microfarad-de/li-charger/doc/li-charger-schematic.png

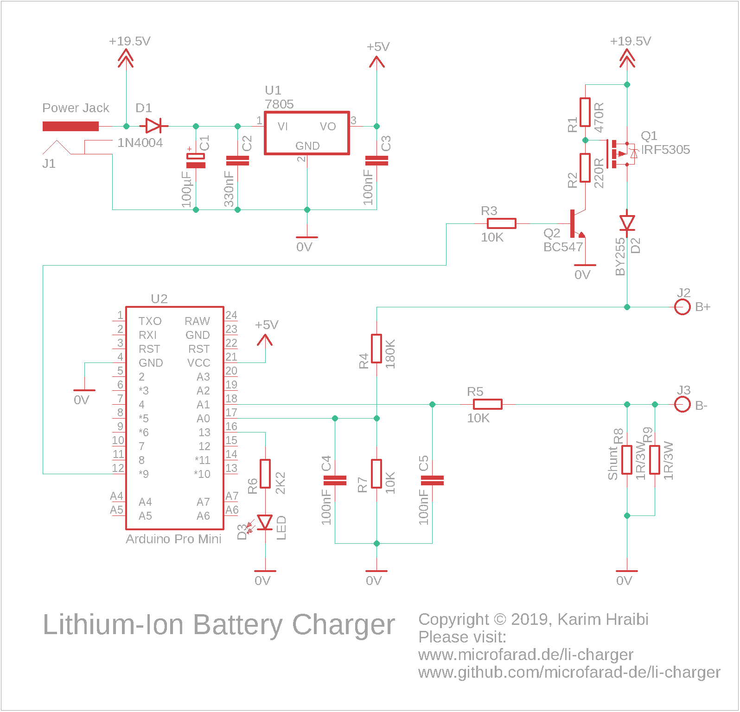
doc/li-charger-schematic.png
