microfarad-de/li-charger/(threads)

Thread 1 (2023-02-20):

Support for 5 cells ?

mtk11, 2023-02-20:
It seems currently 4 cells battery pack are maximum supported ? Possibility to support 5 cells – commonly used in various tools ? As well as simple step-up voltage converter ? Many of the available power supplies are up to 20V.
