microfarad-de/li-charger/li-charger.ino

/*
 * Lithium Battery Charger
 *
 * This source file is part of the Lithium-Ion Battery Charger Arduino firmware
 * found under http://www.github.com/microfarad-de/li-charger
 *
 * Please visit:
 *   http://www.microfarad.de
 *   http://www.github.com/microfarad-de
 *
 * Copyright (C) 2019 Karim Hraibi (khraibi at gmail.com)
 *
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
 * Version: 3.2.1
 * Date:    July 22, 2026
 */
#define VERSION_MAJOR 3  // major version
#define VERSION_MINOR 2  // minor version
#define VERSION_MAINT 1  // maintenance version

#include <avr/sleep.h>
#include <avr/power.h>
#include <avr/wdt.h>
#include <Arduino.h>
#include "src/Cli/Cli.h"
#include "src/Adc/Adc.h"
#include "src/Trace/Trace.h"
#include "src/Nvm/Nvm.h"
#include "src/Led/Led.h"
#include "src/MathMf/MathMf.h"

/*
 * Pin assignment
 */
#define NUM_APINS           2  // Number of analog pins in use
#define VOLTAGE_APIN ADC_PIN0  // Analog pin for voltage measurement
#define CURRENT_APIN ADC_PIN1  // Analog pin for current measurement
#define MOSFET_PIN          9  // PWM pin controlling the gate of the power MOSFET
#define LED_PIN   LED_BUILTIN  // LED pin


/*
 * Configuration parameters
 */
#define SERIAL_BAUD      115200 // Serial communication baud rate
#define V_SURGE         4250000 // 4.25 V - maximum allowed surge voltage threshold per cell in µV
#define V_MAX           4200000 // 4.20 V - Maximum allowed battery voltage per cell in µV
#define V_MIN           2500000 // 2.50 V - Minimum allowed battery voltage per cell in µV
#define V_START           V_MIN // 2.50 V - Minimum allowed battery voltage per cell in µV for starting a charge
#define V_SAFE          2800000 // 2.80 V - Charge with reduced current I_safe below this voltage per cell in µV
#define V_WINDOW           2000 // 0.002 V - Do not regulate voltage when within +/- this window (per cell) in µV
#define V_TRICKLE_START 4100000 // 4.10 V - Trickle charge threshold voltage in µV
#define V_TRICKLE_MAX   4150000 // 4.15 V - Trickle charge maximum voltage in µV
#define I_WINDOW          15000 // 0.015 A - Do not regulate current when within +/- this window in µA
#define I_DIVIDER           128 // Divider constant used for current calculation
#define I_SAFE_DIVIDER       10 // Divide I_chrg by this value to calculate I_safe, which is the reduced safety charging current
#define DELAY_CHARGE       2000 // Time duration in ms during which V shall be between V_MIN and V_MAX before starting to charge
#define DELAY_ERROR         150 // Time duration in ms during which i or V shall be out of bounds in order to trigger an error condition
#define DELAY_FULL        20000 // Time duration in ms during which I_full shall not be exceeded in order to assume that battery is full
#define DELAY_TRICKLE      5000 // Time duration in ms during which V shall be smaller than V_TRICKLE_MAX before starting a trickle charge
#define DELAY_ERR_RST      2000 // Time duration in ms during which V shall be 0 before going back from STATE_ERROR to STATE_INIT
#define DELAY_FULL_RST     2000 // Time duration in ms during which V shall be 0 before going back from STATE_FULL to STATE_INIT
#define DELAY_UPDATE_UP      20 // Number of ADC conversions for increasing the power output by one increment
#define DELAY_UPDATE_DN       1 // Number of ADC conversions  for decreasing the power output by one increment
#define PWM_OC_DETECT_THR   150 // PWM value threshold - detect open circuit if I = 0 while PWM exceeds this value
#define ADC_AVG_SAMPLES      16 // Number of ADC samples to be averaged
#define SOC_LUT_SIZE          9 // Size of the state-of-charge lookup table
#define TRACE_BUF_SIZE      240 // Trace buffer size
#define TRACE_RESOLUTION  60000 // Trace timestamp resolution in ms




/*
 * Objects
 */
LedClass Led;
TraceClass Trace;

/*
 * State machine states
 */
enum State_t { STATE_INIT_E, STATE_INIT, STATE_CHARGE_E, STATE_CHARGE, STATE_FULL_E, STATE_FULL,
                STATE_ERROR_E, STATE_ERROR, STATE_CALIBRATE_E, STATE_CALIBRATE };

/*
 * Global variables
 */
struct {
  State_t state = STATE_INIT_E; // Current state machine state
  uint32_t v1;           // V1 - Voltage at the battery '+' terminal (MOSFET drain) in µV
  uint32_t v2;           // V2 - Voltage at the battery '-' terminal (shunt) in µV
  uint32_t v;            // V  - Battery voltage = V1 - V2 in µV
  uint32_t vMax;         // Maximum allowed battery voltage during charging in µV
  uint32_t i;            // I - Charging current in µA
  uint32_t iMax;         // I_max - Maximum charging current in µA
  uint32_t tMax;         // T_max - Maximum allowed charge time duration in s
  uint32_t iCalibration; // Calibration value for calculating i
  uint32_t c = 0;        // Total charged capacity in mAs
  uint32_t cMax;         // C_max - Maximum allowed charge capacity in mAs
  uint32_t t = 0;        // Charge duration in s
  uint32_t tUpdate;      // Regulation loop update interval in ms
  uint32_t adcTick = 0;  // ADC conversion counter, increments when new ADC results are available
  uint16_t v1Raw;        // Raw ADC value of V1
  uint16_t v2Raw;        // Raw ADC value of V2
  uint16_t iSafe;        // I_safe - Charging current in mA when the battery voltage is below V_SAFE
  uint8_t dutyCycle;     // PWM duty cycle
  char *stateStr;        // Pointer to a string describing the current state
  bool crcOk = false;    // EEPROM CRC check was successful
} G;



/*
 * Parameters stored in EEPROM (non-volatile memory)
 */
struct {
  uint32_t v1Cal;               // V1_cal - Calibration constant for calculating V1
  uint32_t v2Cal;               // V2_cal - Calibration constant for calculating V2
  uint16_t iFull;               // I_full - End of charge current in mA
  uint16_t iChrg;               // I_chrg - Maximum charging current in mA
  uint16_t rShunt;              // R_shunt - Shunt resistor value in mΩ
  uint16_t cFull;               // C_full - Full charge capacity in mAh
  uint8_t  numCells;            // N_cells - Number of Lithium-Ion cells
  uint16_t socLut[SOC_LUT_SIZE];// State-of-charge lookup table - contains voltages in mV
  uint32_t crc;                 // CRC checksum
} Nvm;


/*
 * Strings to be reused for saving memory
 */
const struct {
  char *N_cells = (char *)"N_cells = %u\n";
  char *C_full  = (char *)"C_full  = %umAh\n";
  char *I_chrg  = (char *)"I_chrg  = %umA\n";
  char *I_safe  = (char *)"I_safe  = %umA\n";
  char *I_full  = (char *)"I_full  = %umA\n";
  char *R_shunt = (char *)"R_shunt = %umΩ\n";
  char *V1_cal  = (char *)"V1_cal  = %lu\n";
  char *V2_cal  = (char *)"V2_cal  = %lu\n";
  char *I_cal   = (char *)"I_cal   = %lu\n";
  char *CRC     = (char *)"CRC = %lx\n\n";
  char *reached = (char *)" reached";
  char *Calibration = (char *)"Calibration";
  char *start   = (char *)"start";
  char *stop    = (char *)"stop";
} Str;



/*
 * Function prototypes
 */
bool nvmValidate (void);
void nvmRead (void);
bool nvmWrite (void);
void calcTmaxCmax (bool);
void adcRead (void);
int cmdStatus (int, char **);
int cmdEEPROM (int, char **);
int cmdNcells (int, char **);
int cmdIchrg (int, char **);
int cmdCfull (int, char **);
int cmdIfull (int, char **);
int cmdRshunt (int, char **);
int cmdLut (int, char **);
void calibrateV1 (uint32_t);
void calibrateV2 (uint32_t);
int cmdCal (int, char **);
int cmdTrace (int, char **);




/*
 * Validate the settings
 * Called after reading or before writing EEPROM
 * Always fall-back to the safest possible values
 * Return value:
 *   true  : validation OK
 *   false : validation error
 */
bool nvmValidate (void) {
  bool rv = true;
  if (Nvm.numCells < 0 || Nvm.numCells > 6)         Nvm.numCells = 1          , rv = false;
  if (Nvm.iChrg < 100 || Nvm.iChrg > 2000)          Nvm.iChrg = 100           , rv = false;
  if (Nvm.iFull < 20 || Nvm.iFull > Nvm.iChrg - 20) Nvm.iFull = Nvm.iChrg - 20, rv = false;
  if (Nvm.v1Cal < 4000 || Nvm.v1Cal > 40000)        Nvm.v1Cal = 40000         , rv = false;
  if (Nvm.v2Cal < 800  || Nvm.v2Cal > 1200 )        Nvm.v2Cal = 1200          , rv = false;
  if (Nvm.cFull < 10 || Nvm.cFull > 10000 )         Nvm.cFull = 10            , rv = false;
  if (Nvm.rShunt < 100 || Nvm.rShunt > 1000)        Nvm.rShunt = 100          , rv = false;

  // Calculate current calibration value
  G.iCalibration = ((uint32_t)I_DIVIDER * 1000) / (uint32_t)Nvm.rShunt;

  // Calculate the safe charging current
  G.iSafe = Nvm.iChrg / (uint16_t)I_SAFE_DIVIDER;

  return rv;
}


/*
 * Read and validate EEPROM data
 */
void nvmRead (void) {
  uint32_t crc;

  eepromRead (0x0, (uint8_t*)&Nvm, sizeof (Nvm));
  nvmValidate ();

  // Calculate and check CRC checksum
  crc = crcCalc ((uint8_t*)&Nvm, sizeof (Nvm) - sizeof (Nvm.crc) );
  Cli.xprintf (Str.CRC, crc);

  if (crc != Nvm.crc) G.crcOk = false;
  else G.crcOk = true;
}


/*
 * Write and validate EEPROM data
 * Return value:
 *   true  : validation OK
 *   false : validation error
 */
bool nvmWrite (void) {
  if (nvmValidate ()) {
    Nvm.crc = crcCalc ((uint8_t*)&Nvm, sizeof (Nvm) - sizeof (Nvm.crc) );
    eepromWrite (0x0, (uint8_t*)&Nvm, sizeof (Nvm));
    return true;
  }
  else {
    Cli.xputs ("Out of range");
    return false;
  }
}


/*
 * Claculate the values of
 * the maximum charge duration T_max and
 * the maximum charge capacity C_max
 */
void calcTmaxCmax (bool trickleCharge) {
  uint8_t i, soc;

  // Detect charge state using the lookup table
  for (i = 0; i < SOC_LUT_SIZE; i++) {
    if (G.v < (uint32_t)Nvm.socLut[i] * 1000 * (uint32_t)Nvm.numCells) break;
  }

  // Calculate the state of charge
  soc = (i * 100) / (SOC_LUT_SIZE + 1);

  //Cli.xprintf ("V   = %lu mV\n", G.v / 1000);
  Cli.xprintf ("SoC = %u %%\n", soc);
  Cli.xputs ("");

  /* Calculate the maximum allowed charge duration
     Assume linear increase with capacity intil 80% of charge (constant current phase),
     then add a constant duration of 45 min for the remaining top-off charge (constant voltage phase).
     T_max (s) = 3600 * (C_full / I_chrg) * (90 - SoC) / 100 + 45 * 60s + T_safe
  */
  if (!trickleCharge) {
    // 36 = 3600 / 100
    G.tMax = ( 36 * (90 - soc) * (uint32_t)Nvm.cFull ) / (uint32_t)Nvm.iChrg + 45 * 60;
  }
  else {
    // Allow for 20 charging minutes in every trickle charge cycle
    G.tMax = 20 * 60 + G.t;
  }

  /* Calculate the maximum allowed charge capacity
     C_max (mAs) = 3600 * C_full * 1.31 * (100 - SoC) / 100
     Equals remaining capacity + 31%: 47 = 3600 * 1.31 / 100
  */
  if (!trickleCharge) {
    G.cMax = 47 * (100 - soc) * (uint32_t)Nvm.cFull;
  }
  else {
    // Top-up 3% of C_full for every trickle charge cycle
    G.cMax = 36 * 3 * (uint32_t)Nvm.cFull + G.c;
  }
  Trace.log ('%', soc);
  Trace.log ('v', G.v / 1000);
  Trace.log ('T', G.tMax / 60);
  Trace.log ('C', G.cMax / 3600);
}




/*
 * Arduino initalization routine
 */
void setup (void) {

  MCUSR = 0;      // clear MCU status register
  wdt_disable (); // and disable watchdog

  // Initialize the Timer 1 PWM frequency for pins 9 and 10
  // See https://docs.arduino.cc/tutorials/generic/secrets-of-arduino-pwm/
  // See https://nerdytechy.com/how-to-change-the-pwm-frequency-of-arduino/
  // See https://etechnophiles.com/change-frequency-pwm-pins-arduino-uno/
  // See ATmega328P datasheet Section 20.14.2, Table 20-7
  TCCR1B = (TCCR1B & B11111000) | B00000001; // For PWM frequency of 31372.55Hz (using 16MHz crystal)

  // Configure all unused pins as INPUT_PULLUP to avoid
  // excessive power draw due to toggling floating pins
  // except crystal pins
  DDRB  = 0x00;
  DDRC  = 0x00;
  DDRD  = 0x00;
  PORTB = 0x3F;   // D8–D13 pull-ups enabled
  PORTC = 0x3F;   // A0–A5 pull-ups enabled
  PORTD = 0xFF;   // D0–D7 pull-ups enabled

  // Initialize pins
  pinMode (A0, INPUT);
  pinMode (A1, INPUT);
  pinMode (MOSFET_PIN, OUTPUT);

  // Initialize the command-line interface
  Cli.init (SERIAL_BAUD);
  Cli.xputs ("");
  Cli.xputs ("+ + +  L I  C H A R G E R  + + +");
  Cli.xputs ("");
  Cli.xprintf ("V %d.%d.%d\n", VERSION_MAJOR, VERSION_MINOR, VERSION_MAINT);
  Cli.xputs ("");
  Cli.newCmd (".", "System status", cmdStatus);
  Cli.newCmd ("r", "EEPROM status", cmdEEPROM);
  Cli.newCmd ("t", "Dump trace", cmdTrace);
  Cli.newCmd ("ncells", "Set N_cells", cmdNcells);
  Cli.newCmd ("cfull", "Set C_full (arg: <mAh>)", cmdCfull);
  Cli.newCmd ("ichrg", "Set I_chrg (arg: <mA>)", cmdIchrg);
  Cli.newCmd ("ifull", "Set I_full (arg: <mA>)", cmdIfull);
  Cli.newCmd ("lut", "Set LUT (arg: <idx> <mV>)", cmdLut);
  Cli.newCmd ("rshunt", "Set R_shunt (arg: <mΩ>)", cmdRshunt);
  Cli.newCmd ("cal", "Calibrate (arg: <start|stop|v1|v2> [mV])", cmdCal);

  Cli.showHelp ();

  // Initialize the ADC
  Adc.initialize (ADC_PRESCALER_128, ADC_INTERNAL, NUM_APINS, ADC_AVG_SAMPLES);

  // Initialize LED
  Led.initialize (LED_PIN);

  // Read the settngs from EEPROM and validate them
  nvmRead ();

  // Initialize the trace buffer
  Trace.initialize (sizeof(Nvm), TRACE_BUF_SIZE, TRACE_RESOLUTION);

  // Enable the watchdog
  wdt_enable (WDTO_1S);
}


/*
 * Arduino main loop
 */
void loop (void) {
  static uint32_t tickTs = 0;
  static uint32_t updateTs = 0;
  static uint32_t chargeTs = 0;
  static uint32_t errorTs = 0;
  static uint32_t fullTs = 0;
  static uint32_t trickleTs = 0;
  static uint32_t resetTs = 0;
  static uint16_t traceCount = 0;
  static bool safeCharge = true;
  static bool trickleCharge = false;
  uint32_t ts = millis ();

  // Reset the watchdog timer
  wdt_reset ();

  // Enter the power save mode - reduces accuracy of c calculation
  //powerSave ();

  // Command-line interpreter
  Cli.getCmd ();

  // Update the LED state
  Led.loopHandler ();

  // Update the trace timestamp - must be called after 'ts = millis ()'
  Trace.loopHandler ();

  // Read the ADC channels
  adcRead ();

  // Force the error STATE if CRC error occurred
  if (!G.crcOk && G.state != STATE_ERROR) Cli.xprintf ("CRC "), Trace.log ('E', 99), G.state = STATE_ERROR_E;


  // Main state machine
  switch (G.state) {

    /********************************************************************/
    // Initialization State
    case STATE_INIT_E:
      Led.blink (-1, 500, 1500);
      trickleCharge = false;
      Trace.reset ();
      G.vMax = (uint32_t)V_MAX * Nvm.numCells;
      chargeTs = ts;
      G.dutyCycle = 0;
      analogWrite (MOSFET_PIN, 0);
      G.stateStr = (char *)"Waiting for battery";
      Cli.xputs (G.stateStr);
      Cli.xputs ("");
      G.state = STATE_INIT;
    case STATE_INIT:
      // Start charging if V stays within bounds during DELAY_CHARGE
      if ( G.v < (uint32_t)V_START * Nvm.numCells || G.v > G.vMax ) chargeTs = ts;
      if (ts - chargeTs > DELAY_CHARGE) {
        G.c = 0;
        G.t = 0;
        G.state = STATE_CHARGE_E;
      }
      break;

    /********************************************************************/
    // Charging State
    case STATE_CHARGE_E:
      Led.turnOn ();
      errorTs = ts;
      fullTs = ts;
      tickTs = ts;
      updateTs = G.adcTick;
      G.iMax = (uint32_t)G.iSafe * 1000;
      safeCharge = true;
      Trace.start ();
      traceCount = 0;
      if (trickleCharge) {
        G.vMax = (uint32_t)V_TRICKLE_MAX * Nvm.numCells; // Reduce vMax to trickle charge level
        G.stateStr = (char *)"Trickle charging";
      }
      else  {
        G.vMax = (uint32_t)V_MAX * Nvm.numCells; // Set vMax to full charge level
        G.stateStr = (char *)"Charging";
      }
      Cli.xputs (G.stateStr);
      Cli.xputs ("");
      Trace.log ('*', G.vMax / 1000);
      calcTmaxCmax (trickleCharge);
      if (G.v <= (uint32_t)V_SAFE * Nvm.numCells) Trace.log ('S', G.iMax / 1000);
      G.state = STATE_CHARGE;

    case STATE_CHARGE:
      // Temporarily increase the PWM update rate to mitigate voltage or current surge conditions
      if ( ( G.v > G.vMax + 10 * (uint32_t)V_WINDOW * Nvm.numCells ) ||
           ( G.i > G.iMax + 10 * (uint32_t)I_WINDOW ) ) {
        G.tUpdate = (uint32_t)DELAY_UPDATE_DN;
      }
      else {
        G.tUpdate = (uint32_t)DELAY_UPDATE_UP;
      }

      // CC-CV Regulation:
      // Run the regulation routine at the preset interval
      if (G.adcTick - updateTs > G.tUpdate) {
        updateTs = G.adcTick;
        // Regulate voltage and current with the CC-CV algorithm
        if ( ( G.v > G.vMax + (uint32_t)V_WINDOW * Nvm.numCells ) ||
             ( G.i > G.iMax + (uint32_t)I_WINDOW ) ) {
          if (G.dutyCycle > 0) G.dutyCycle--;
        }
        else if ( ( G.v < G.vMax - (uint32_t)V_WINDOW * Nvm.numCells ) &&
                  ( G.i < G.iMax - (uint32_t)I_WINDOW ) ) {
          if (G.dutyCycle < 255) G.dutyCycle++;
        }
        // Update the PWM duty cycle
        analogWrite (MOSFET_PIN, G.dutyCycle);
      }

      // Set the charging current
      if (G.v > (uint32_t)V_SAFE * Nvm.numCells && safeCharge) {
        safeCharge = false;
        G.iMax = (uint32_t)Nvm.iChrg * 1000;
        Trace.log ('I', G.iMax / 1000);
      }

      // Error Detection:
      // Signal an error if V stays out of bounds or open circuit condition occurs during DELAY_ERROR
      if ( G.v > (uint32_t)V_MIN   * Nvm.numCells &&
           G.v < (uint32_t)V_SURGE * Nvm.numCells &&
           !( G.i == 0 && G.dutyCycle > PWM_OC_DETECT_THR ) ) errorTs = ts;
      if (ts - errorTs > DELAY_ERROR) {
        cmdStatus (0, NULL);
        if (G.v > (uint32_t)V_SURGE * Nvm.numCells)       Cli.xprintf ("Overvolt "), Trace.log ('E', 1);
        if (G.v < (uint32_t)V_MIN * Nvm.numCells  )       Cli.xprintf ("Undervolt "), Trace.log ('E', 2);
        if (G.i == 0 && G.dutyCycle > PWM_OC_DETECT_THR)  Cli.xprintf ("Open circuit "), Trace.log ('E', 3);
        G.state = STATE_ERROR_E;
      }

      // End of Charge Detection:
      // Report battery full if I_full has not been exceeded during DELAY_FULL (ignore during safety charging)
      if ( G.i > (uint32_t)Nvm.iFull * 1000 || safeCharge ) fullTs = ts;
      if (ts - fullTs > DELAY_FULL) {
        cmdStatus (0, NULL);
        Cli.xprintf("I_full");
        Cli.xputs(Str.reached);
        Trace.log ('F', 1);
        G.state = STATE_FULL_E;
      }

      // Calculate charged capacity by integrating i over time
      if (ts - tickTs >= 1000 /* && !trickleCharge */) {
        tickTs += 1000;
        G.t++;
        G.c += (G.i / 1000);
        traceCount++;
        if (traceCount >= 120) {
          Trace.log ('v', G.v / 1000);
          Trace.log ('i', G.i / 1000);
          traceCount = 0;
        }
      }

      // End of Charge Detection:
      // Maximum charge capacity is reached
      if (G.c > G.cMax) {
        cmdStatus (0, NULL);
        Cli.xprintf ("C_max"); Cli.xputs(Str.reached);
        Trace.log ('F', 2);
        G.state = STATE_FULL_E;
      }

      // End of Charge Detection:
      // Maximum charge duration reached
      if (G.t > G.tMax) {
        cmdStatus (0, NULL);
        Cli.xprintf ("T_max"); Cli.xputs(Str.reached);
        Trace.log ('F', 3);
        G.state = STATE_FULL_E;
      }
      break;

    /********************************************************************/
    // Battery Full State
    case STATE_FULL_E:
      Led.blink (-1, 100, 1900);
      trickleTs = ts;
      resetTs = ts;
      G.dutyCycle = 0;
      analogWrite (MOSFET_PIN, 0);
      G.stateStr = (char *)"Battery full";
      Cli.xputs (G.stateStr);
      Cli.xputs ("");
      Trace.log ('t', G.t / 60);
      Trace.log ('c', G.c / 3600);
      Trace.log ('v', G.v / 1000);
      Trace.log ('i', G.i / 1000);
      G.state = STATE_FULL;
    case STATE_FULL:
      // Start a trickle charging cycle if V_TRICKLE_START has not been exceeded during DELAY_TRICKLE
      if (G.v > (uint32_t)V_TRICKLE_START * Nvm.numCells) trickleTs = ts;
      if (ts - trickleTs > DELAY_TRICKLE) {
        cmdStatus (0, NULL);
        trickleCharge = true;
        G.state = STATE_CHARGE_E;
      }
      // Go to STATE_INIT if V stayed 0 during DELAY_RESET
      if (G.v > 0) resetTs = ts;
      if (ts - resetTs > DELAY_FULL_RST) G.state = STATE_INIT_E;
      break;

    /********************************************************************/
    // Error State
    case STATE_ERROR_E:
      Led.blink (-1, 200, 200);
      resetTs = ts;
      G.dutyCycle = 0;
      analogWrite (MOSFET_PIN, 0);
      G.stateStr = (char *)"ERROR";
      Cli.xputs (G.stateStr);
      Cli.xputs ("");
      Trace.log ('t', G.t / 60);
      Trace.log ('c', G.c / 3600);
      Trace.log ('v', G.v / 1000);
      Trace.log ('i', G.i / 1000);
      G.state = STATE_ERROR;
    case STATE_ERROR:
      // Go to STATE_INIT if V stayed 0 during DELAY_RESET
      if (G.v > 0) resetTs = ts;
      if (ts - resetTs > DELAY_ERR_RST && G.crcOk) G.state = STATE_INIT_E;
      break;


    /********************************************************************/
    // Calibration State
    case STATE_CALIBRATE_E:
      Led.blink (-1, 100, 100);
      G.dutyCycle = 0;
      analogWrite (MOSFET_PIN, 0);
      G.stateStr = Str.Calibration;
      G.state = STATE_CALIBRATE;
    case STATE_CALIBRATE:
      // Do nothing and wait for a CLI command
      break;

    /********************************************************************/
    default:
      break;
  }
}





/*
 * Read the ADC channels
 */
void adcRead (void) {
  bool result;

  // Read the ADC channels
  result = Adc.readAll ();

  if (result) {
    // Get the ADC results
    G.v1Raw = (uint16_t)Adc.result[VOLTAGE_APIN];
    G.v2Raw = (uint16_t)Adc.result[CURRENT_APIN];

    // Calculate voltage and current
    G.v1 = (uint32_t)G.v1Raw * Nvm.v1Cal;
    G.v2 = (uint32_t)G.v2Raw * Nvm.v2Cal;
    G.v  = G.v1 - G.v2;
    G.i  = ( (uint32_t)G.v2 * G.iCalibration ) / I_DIVIDER ;
    G.adcTick++;
  }
}


/*
 * Power-save routine, sends the CPU into sleep mode
 */
void powerSave (void) {
  // configure lowest sleep mode that keeps clk_IO for Timer 1 used for PWM generation
  set_sleep_mode (SLEEP_MODE_IDLE);

  // enter sleep, wakeup will be triggered by the next millis() interrupt
  cli ();
  sleep_enable ();
  sei ();
  sleep_cpu ();
  sleep_disable ();
}





/*
 * CLI command for showing the real-time parameters
 * These values are continuously updated during runtime.
 */
int cmdStatus (int argc, char **argv) {
  uint32_t hour = G.t / 3600;
  uint32_t min = G.t / 60 - (hour * 60);
  uint32_t sec = G.t - (hour * 3600) - (min * 60);
  Cli.xprintf ("state  = %s\n", G.stateStr);
  Cli.xprintf ("T      = %02u:%02u:%02u\n", (uint8_t)hour, (uint8_t)min, (uint8_t)sec);
  Cli.xprintf ("C      = %lumAh\n", G.c / 3600);
  Cli.xprintf ("V      = %lumV\n", G.v / 1000);
  Cli.xprintf ("I      = %lumA\n", G.i / 1000);
  Cli.xprintf ("T_max  = %lumin\n", G.tMax / 60);
  Cli.xprintf ("C_max  = %lumAh\n", G.cMax / 3600);
  Cli.xprintf ("V_max  = %lumV\n", G.vMax / 1000);
  Cli.xprintf ("I_max  = %lumA\n", G.iMax / 1000);
  Cli.xprintf ("PWM    = %u\n", G.dutyCycle);
  Cli.xprintf ("V1     = %lumV\n", G.v1 / 1000);
  Cli.xprintf ("V2     = %lumV\n", G.v2 / 1000);
  Cli.xprintf ("V1_raw = %u\n", G.v1Raw);
  Cli.xprintf ("V2_raw = %u\n", G.v2Raw);
  Cli.xputs ("");
  return 0;
}


/*
 * CLI command for showing calibration parameters
 * These values do not change during runtime.
 * They are either directly read from EEPROM or
 * derived from other EEPROM values.
 */
int cmdEEPROM (int argc, char **argv) {
  uint8_t i;
  Cli.xprintf (Str.N_cells, Nvm.numCells);
  Cli.xprintf (Str.C_full,  Nvm.cFull);
  Cli.xprintf (Str.I_chrg,  Nvm.iChrg);
  Cli.xprintf (Str.I_safe,  G.iSafe);
  Cli.xprintf (Str.I_full,  Nvm.iFull);
  Cli.xprintf (Str.R_shunt, Nvm.rShunt);
  Cli.xprintf (Str.V1_cal,  Nvm.v1Cal);
  Cli.xprintf (Str.V2_cal,  Nvm.v2Cal);
  Cli.xprintf (Str.I_cal,   G.iCalibration);
  Cli.xprintf ("LUT = ");
  for (i = 0; i < SOC_LUT_SIZE; i++) Cli.xprintf("%u ", Nvm.socLut[i]);
  Cli.xputs ("");
  Cli.xputs ("");
  return 0;
}


/*
 * CLI command for setting the number of cells
 * argv[1]: number of cells
 */
int cmdNcells (int argc, char **argv) {
  if (argc != 2) return 1;
  uint8_t tmp = Nvm.numCells;
  Nvm.numCells = atoi (argv[1]);
  if (nvmWrite ()) Cli.xprintf (Str.N_cells, Nvm.numCells);
  else             Nvm.numCells = tmp;
  Cli.xputs ("");
  G.state = STATE_INIT_E;
  return 0;
}


/*
 * CLI command for setting the charge current
 * argv[1]: current in mA
 */
int cmdIchrg (int argc, char **argv) {
  if (argc != 2) return 1;
  uint16_t tmp1 = Nvm.iChrg;
  uint16_t tmp2 = Nvm.iFull;
  Nvm.iChrg = atoi (argv[1]);
  if (nvmWrite ()) {
    Cli.xprintf(Str.I_chrg, Nvm.iChrg);
  }
  else {
    Nvm.iChrg = tmp1;
    Nvm.iFull = tmp2;
  }
  Cli.xputs("");
  return 0;
}


/*
 * CLI command for setting the end of charge current
 * argv[1]: current in mA
 */
int cmdIfull (int argc, char **argv) {
  if (argc != 2) return 1;
  uint16_t tmp = Nvm.iFull;
  Nvm.iFull = atoi (argv[1]);
  if (nvmWrite ()) Cli.xprintf(Str.I_full, Nvm.iFull);
  else             Nvm.iFull = tmp;
  Cli.xputs("");
  return 0;
}


/*
 * CLI command for setting the battery capacity
 * argv[1]: battery capacity in mAh
 */
int cmdCfull (int argc, char **argv) {
  if (argc != 2) return 1;
  uint16_t tmp = Nvm.cFull;
  Nvm.cFull = atoi (argv[1]);
  if (nvmWrite ()) Cli.xprintf(Str.C_full, Nvm.cFull);
  else             Nvm.cFull = tmp;
  Cli.xputs("");
  return 0;
}


/*
 * CLI command for setting the shunt resistor value
 * argv[1]: shunt resistance in mΩ
 */
int cmdRshunt (int argc, char **argv) {
  if (argc != 2) return 1;
  uint16_t tmp = Nvm.rShunt;
  Nvm.rShunt = atoi (argv[1]);
  if (nvmWrite ()) {
    Cli.xprintf(Str.R_shunt, Nvm.rShunt);
    Cli.xprintf(Str.I_cal, G.iCalibration);
  }
  else {
    Nvm.rShunt = tmp;
  }
  Cli.xputs("");
  return 0;
}


/*
 * CLI command for filling the state-of-charge lookup table
 * argv[1]: idx [0..8]
 *          V = LUT [idx]
 *          idx:    0     1     2     3     4     5     6     7     8
 *          SoC: 0% | 10% | 20% | 30% | 40% | 50% | 60% | 70% | 80% | 90%
 * argv[2]: voltage in mV per cell
 */
int cmdLut (int argc, char **argv) {
  if (argc != 3) return 1;
  uint8_t idx = (uint8_t)atoi (argv[1]);
  if (idx > SOC_LUT_SIZE - 1) return 1;
  Nvm.socLut[idx] = atoi (argv[2]);
  nvmWrite ();
  Cli.xprintf ("LUT[%u] = %u\n", idx, Nvm.socLut[idx]);
  Cli.xputs ("");
  return 0;
}


/*
 * Calibrate V1
 */
void calibrateV1 (uint32_t vRef) {
  uint32_t tmp = Nvm.v1Cal;
  Nvm.v1Cal = (uint32_t)vRef / (uint32_t)G.v1Raw;
  if (nvmWrite ()) Cli.xprintf (Str.V1_cal, Nvm.v1Cal);
  else             Nvm.v1Cal = tmp;
  Cli.xputs ("");
}


/*
 * Calibrate V2
 */
void calibrateV2 (uint32_t vRef) {
  uint32_t tmp = Nvm.v2Cal;
  Nvm.v2Cal = (uint32_t)vRef / (uint32_t)G.v2Raw;
  if (nvmWrite ()) Cli.xprintf (Str.V2_cal, Nvm.v2Cal);
  else             Nvm.v2Cal = tmp;
  Cli.xputs ("");
}


/*
 * CLI command for calibrating V1 and V2
 * argv[1]:
 *   start : start calibration mode
 *   stop  : stop calibration mode
 *   v1 : calibrate V1
 *   v2 : calibrate V2
 */
int cmdCal (int argc, char **argv) {
  if (G.state == STATE_CALIBRATE) {
    uint32_t vRef = (uint32_t)atoi(argv[2]) * 1000;
    if      (strcmp(argv[1], "v1") == 0 && argc == 3) calibrateV1 (vRef);
    else if (strcmp(argv[1], "v2") == 0 && argc == 3) calibrateV2 (vRef);
    else if (strcmp(argv[1], Str.stop) == 0) {
      G.state = STATE_INIT_E;
      Cli.xprintf ("%s %s\n", Str.Calibration, Str.stop);
      Cli.xputs ("");
    }
  }
  else if (strcmp(argv[1], Str.start) == 0) {
    G.state = STATE_CALIBRATE_E;
    Cli.xprintf ("%s %s\n", Str.Calibration, Str.start);
    Cli.xputs ("");
  }
  return 0;
}


/*
 * CLI command for dumping the trace buffer
 */
int cmdTrace (int argc, char **argv) {
  Trace.dump ();
  return 0;
}
