microfarad-de/li-charger/(commit log)

2018-12-29 Implemented basic voltage regulation
2018-12-30 Minor fixes, added schematic
    [li-charger.ino]
2018-12-30 Adjust LED blinking period
2019-01-02 Discontinue ADC enable circuitry
2019-01-02 Bugfix: multiply V_SURGE by numCells
    [li-charger.ino]
2019-01-03 Additional features
    - Charge duration
    - Charge capacity
    - ADC averaging
2019-01-03 Tweakin
    - Remove IIR filter
    - Parameter tweak
2019-01-04 Introduced the calibration mode
2019-01-04 Tested calibration mode
2019-01-13 Introduce open circuit detection and CRC check
2019-01-13 Swithch to FULL instead of ERROR state when reaching T_max
    [li-charger.ino]
2019-01-16 Reduced charging current at very low voltages
2019-01-17 Optimze and test
    - Reuse strings in different places to save memory
    - I_safe is now a factor of I_chrg
    - Test very low voltage use cases
    - Test I_safe
    - Test Trickle Charging
2019-01-18 State of Charge Estimation
    - Estimate SoC via voltage lookup table
    - Calculate timeout and expected capacity based on SoC
    - Optimized memory usage
2019-01-18 Optimize trickle charging
2019-01-19 More headroom for time and capacity based cutoff
2019-01-19 Improve trace
2019-01-20 Support depleted LiIon with BMS
2019-01-20 Optimize low voltage BMS recovery
2019-01-20 Fine-tune timestamps
    And stabilize regulation
    [li-charger.ino]
2019-01-20 Reduce error recovery timeout
    [li-charger.ino]
2019-01-28 Fix comment, add PNG schematic and BOM
    [li-charger-bom.csv]
2019-02-02 Updated li-charger schematic, use BY255 diode
2019-02-02 Updated schematic
2019-06-20 Update and rename adc.cpp to ADC.cpp
2019-06-20 Update and rename trace.cpp to Trace.cpp
2019-06-20 Update and rename ADC.h to Adc.h
2019-06-20 Refactor Adc
2019-06-23 Increase PWM frequency, imporve CLI
    - Increase PWM frequency to 31250 Hz
    - Harmonize the CLI with pi-ups
    - Refactor
2019-06-23 Increase V_max to 4.2 V/cell
2019-06-24 Fix R_shunt default value, tidy
    [li-charger.ino]
2019-06-25 Do not write to EEPROM if validation fails
    Display error message upon parameter validation failure and do not write EEPROM.
    [li-charger.ino]
2019-06-26 Synchronize PWM update interval with adcRead()
2019-06-26 Print current state in the system status
    Also increase PWM update interval to 20 ADC cycles
2019-09-26 Fixed file name capitalization error
    [li-charger.ino]
2020-03-11 Adding Adc submodule
2020-03-11 Add Adc symlinks
2020-03-11 Add Trace submodule
2020-03-11 Update trace submodule
2023-04-24 Fixed potential bug that could prevent sudden undervoltage detection due to a short circuit and removed makeshift NiCd battery support.
    [li-charger.ino]
2024-09-16 Fixed wrong comment about PWM frequency value.
    [li-charger.ino]
2026-07-10 Updated trace library
2026-07-22 Configure all unused pins as INPUT_PULLUP to avoid excessive power draw due to floating pin toggle
    [li-charger.ino]
